gnen54/openccu-gartenfeuchtemesser/gehaeuse/gehaeuse_deckel.stl

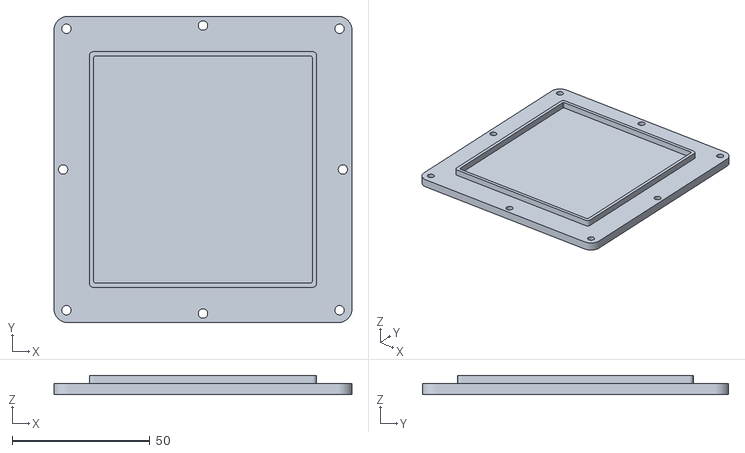
[picture p2: CAD file, 2026-11-01]
gehaeuse/gehaeuse_deckel.stl
108.0 x 111.0 x 7.01
