gnen54/openccu-gartenfeuchtemesser/gehaeuse/gehaeuse_unterteil.stl

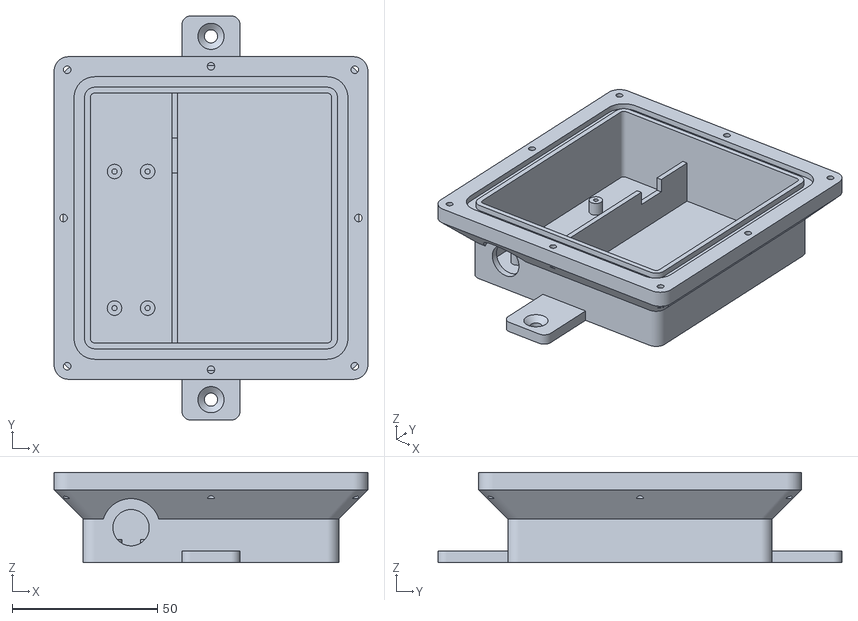
[picture p3: CAD file, 2026-11-01]
gehaeuse/gehaeuse_unterteil.stl
108.0 x 139.0 x 31.0
