gnen54/openccu-gartenfeuchtemesser/(commit log)

2026-11-01 OpenCCU Gartenfeuchtemesser: Pico W und Raspberry Pi 3, Meldung an OpenCCU
    - Capacitive Soil Moisture Sensor v1.2, Kalibrierung trocken/nass, Hysterese
    - Systemvariablen per Remote Homematic-Script API (ohne Zusatzsoftware)
    - Waechter-Programm und Skript zum Anlegen der Variablen
    - Webseite, Siri-Abfrage und Akku-Waechter wie bei Rolltor/Startampel
    - Alle IP-Adressen sind neutrale Beispiele
    Claude-Session: https://claude.ai/code/session_017SRKzvM3CUUX4Br3t83krF
2026-11-01 Gehaeuse: wasserdichtes 3D-Druck-Gehaeuse mit Akkuschacht (4 x AA)
    - STL fuer Unterteil und Deckel, anpassbare OpenSCAD-Vorlage, Erzeuger-Skript
    - Dichtnut fuer 3-mm-Rundschnur, 8 Deckelschrauben, Befestigungslaschen, PG7
    - Einkaufsliste mit Bezugsquellen, Druck- und Montagehinweise
    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
    [gehaeuse.scad, gehaeuse_deckel.stl, gehaeuse_unterteil.stl]
2026-11-01 Gehaeuse: Akkuschacht fuer flachen 4,8-V-Akkupack 56,8 x 51 x 14,5 mm
    - Akku liegt flach neben dem Pico, Gehaeuse breiter und flacher (35 mm tief)
    - flache Auflage fuer die Kabelverschraubung PG7
    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
    [gehaeuse.scad, gehaeuse_deckel.stl, gehaeuse_unterteil.stl]
2026-11-01 Sparmodus wie bei der LED-Uhr: WLAN-Fenster zur vollen Stunde, Messung alle 15 min, lightsleep
    - WLAN nur hh:00-hh:05 und nach dem Einschalten, auf der Seite um 30 min verlaengerbar
    - dazwischen WLAN nur kurz fuer die Meldung an die OpenCCU, Pico schlaeft
    - README: Sparmodus und Laufzeitschaetzung
    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
